jg925/ece3400_2019-team10/README.md

# ECE 3400 Team 10 Website

[Click here to view website.](https://pages.github.coecis.cornell.edu/jg925/ece3400-2019-team10/)

Source for \_config.yml from [this site.](https://nicolas-van.github.io/easy-markdown-to-github-pages/)
