jg925/ece3400_2019-team10/Competition Code/DFS_with_integration/readme.md

# newDFSwithIntegration

This Arduino file contains what ran on our robot during the competition. It includes the DFS algorithm and FFT algorithms, and takes in data from the various sensors on the robot.
