jg925/ece3400_2019-team10/Competition Code/FPGA_VGA_Code/readme.md

# FPGA_to_VGA_code

This Verilog code allows us to take in data about the robot's current position and where it detects walls to accurately draw a map of the maze on a display.
