jg925/ece3400_2019-team10/Competition Code/Radio_Receiver/readme.md

# Radio Receiver

This Arduino file receives data the robot is transmitting through the on-board radio. It then modifies this data so we can send it to the FPGA to be drawn on the display.
