jg925/ece3400_2019-team10/labs/lab1/media/circuit.png

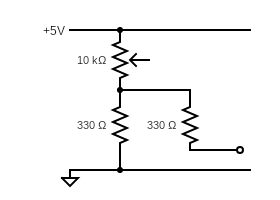
labs/lab1/media/circuit.png
