jg925/ece3400_2019-team10/labs/lab2/images/220px-Electret_condenser_microphone_schematic.png

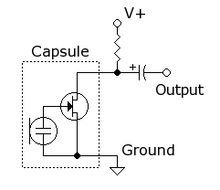
labs/lab2/images/220px-Electret_condenser_microphone_schematic.png
