jg925/ece3400_2019-team10/labs/lab2/images/20191011_132111.jpg

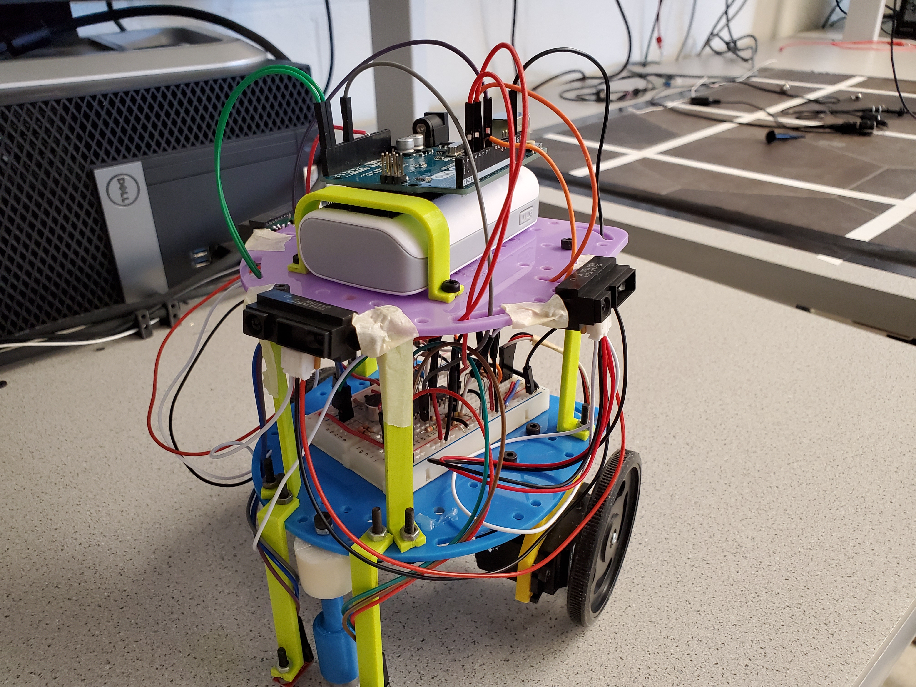
labs/lab2/images/20191011_132111.jpg
