jg925/ece3400_2019-team10/labs/lab2/images/schmitt_trigger-2.jpg

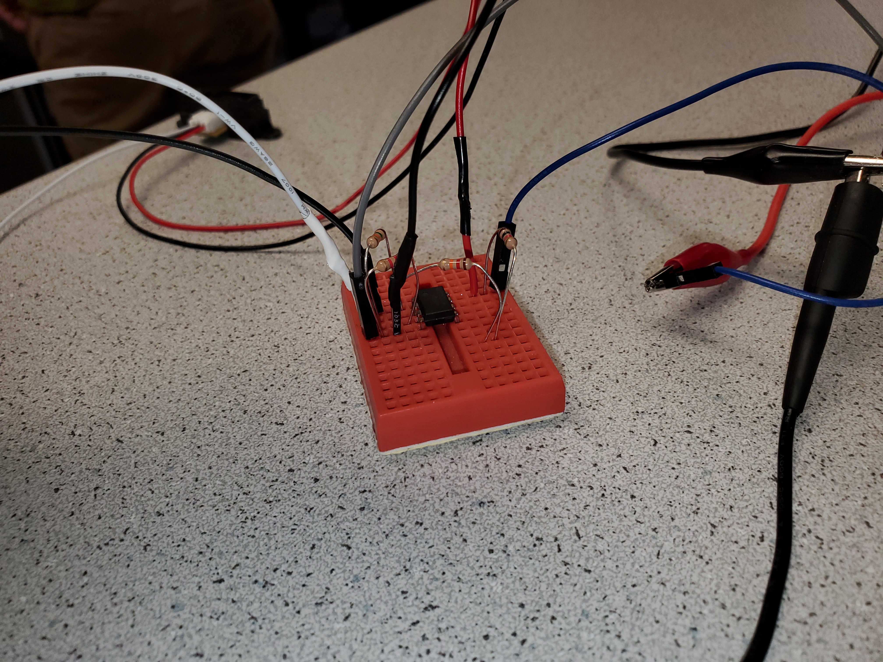
labs/lab2/images/schmitt_trigger-2.jpg
