jg925/ece3400_2019-team10/labs/lab2/images/SchmittTrigger.png

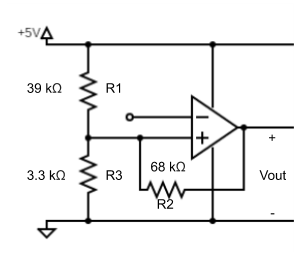
labs/lab2/images/SchmittTrigger.png
