jg925/ece3400_2019-team10/labs/lab3/circuit.jpg

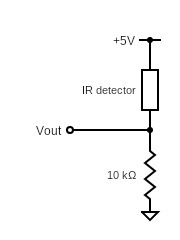
labs/lab3/circuit.jpg
