jg925/ece3400_2019-team10/labs/lab4/Detector.png

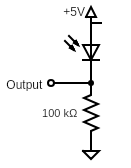
labs/lab4/Detector.png
