jg925/ece3400_2019-team10/milestones/ir.jpg

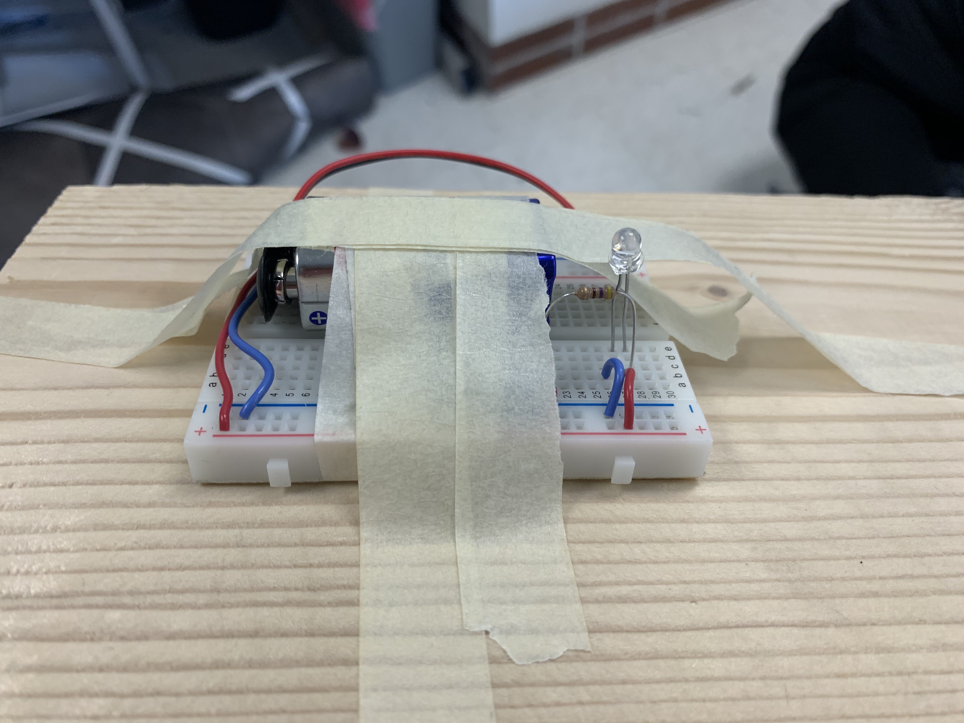
milestones/ir.jpg
