jg925/ece3400_2019-team10/milestones/teamphoto.jpg

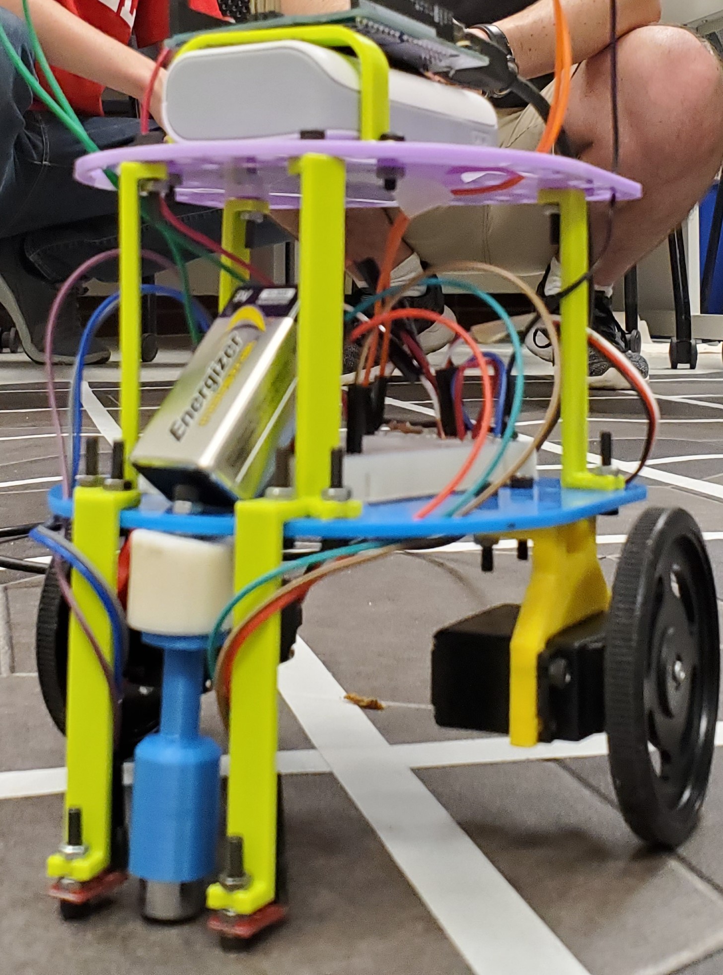
milestones/teamphoto.jpg
