jg925/ece3400_2019-team10/teamphoto.jpg

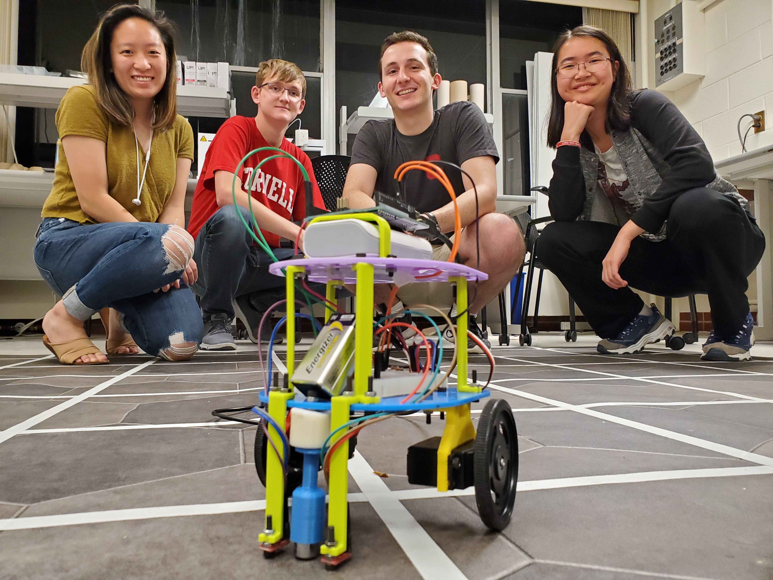
teamphoto.jpg
