jg925/ece3400_2019-team10/labs/lab1/media/potentiometer_setup.jpg

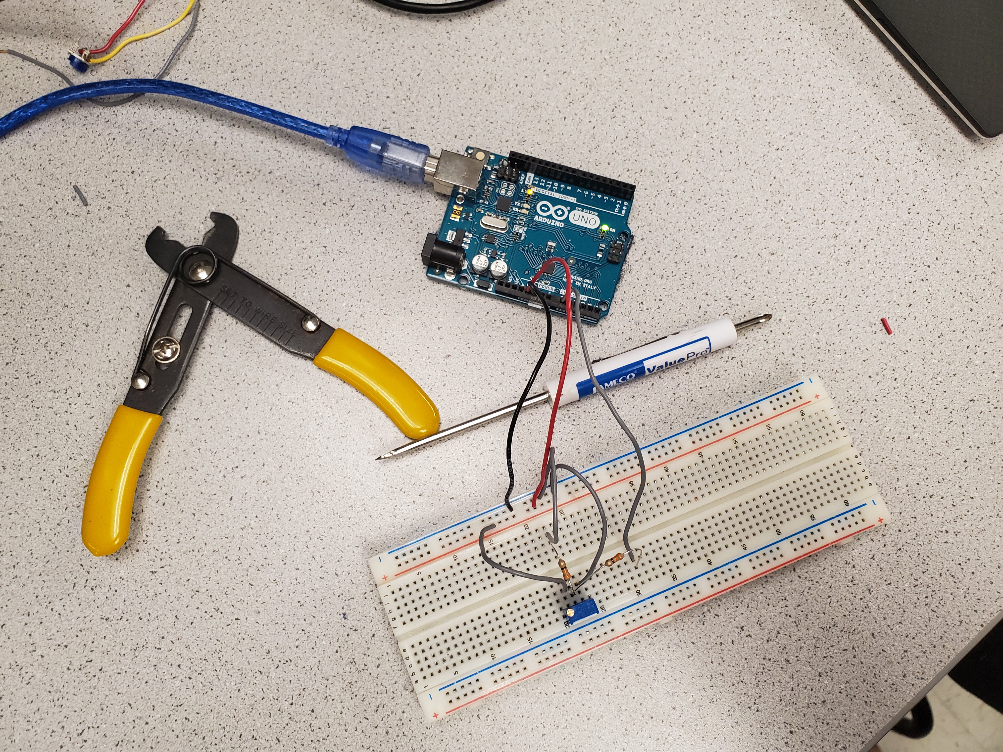
labs/lab1/media/potentiometer_setup.jpg
