jg925/ece3400_2019-team10/labs/lab4/Lab4_FPGA_Template/Dual_Port_RAM_M9K.v

`define SCREEN_WIDTH 330
`define SCREEN_HEIGHT 330

module Dual_Port_RAM_M9K(
	input_data,
	w_addr,
	r_addr,
	w_en,
	clk_W,
	clk_R,
	output_data
);

//=======================================================
//  PORT declarations
//=======================================================

//////////// CLOCKS //////////
input 		          		clk_W, clk_R;

//////////// input enables (write, read) //////////
input 		    				w_en;

//////////// write and read addresses //////////
input 		    [17:0]		w_addr;
input 		    [17:0]		r_addr;

//////////// input/output data busses //////////
//input 		    [7:0]		input_data;
//output reg 		 [7:0]		output_data;
input 		[1:0] 	input_data;
output reg 	[1:0]    output_data;

//////////// memory array //////////
//(* ramstyle = "M9K" *) reg	[7:0]	 mem [(`SCREEN_WIDTH * `SCREEN_HEIGHT)-1:0];
(* ramstyle = "M9K" *) reg [1:0] mem [(`SCREEN_WIDTH * `SCREEN_HEIGHT)-1:0];
reg				 [17:0]		r_addr_reg;


///// WRITE BLOCK /////
always @ (posedge clk_W) begin
	if(w_en) 
		mem[w_addr] <= input_data;
end

///// READ BLOCK  /////
always @ (posedge clk_R) begin
	output_data <= mem[r_addr];
	r_addr_reg <= r_addr;
end

endmodule
