jg925/ece3400_2019-team10/(commit log)

2019-09-10 added arduino files from lab 1
2019-09-15 Add headings and materials
2019-09-15 Add blinking external led video
2019-09-17 Add servos videos
2019-09-18 Add circuit schematic
2019-09-18 test 3 button mode
2019-09-18 return to one button mode
2019-09-20 worked on navigating the robot using line sensors
2019-10-07 Add y axis label
2019-10-07 fixed 950 hz detection
    [Lab2_FFT.ino]
2019-10-10 updated lab 2 stuff because dan decided to change the circuit
2019-11-19 Fixed some bin stuff
    [Lab2_FFT.ino]
2019-12-02 fast servos
2019-12-04 fpga arduino code
